epsilonrt/gp2-i2c/hardware/proto/lpkf/gp2-i2c - CADCAM Mechanical 1.TXT

G04 PROTEUS RS274X GERBER FILE*
%FSLAX24Y24*%
%MOIN*%
%ADD71C,0.0080*%
G54D71*
X-984Y-3937D02*
X+12795Y-3937D01*
X+12795Y+1574D01*
X-984Y+1574D01*
X-984Y-3937D01*
M00*
