epsilonrt/gp2-i2c/doc/gp2-mesures.odt

# Mesures

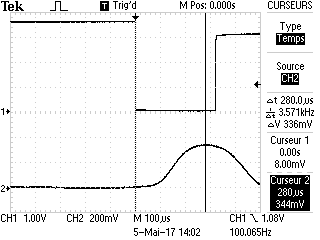
[picture p2: figure]

| C1 : LED Pin3 C2 : VO Pin5 Moyenne sur 16 courbes Pas de fumée Mesure délai échantillonnage 280µs Mesure VO à 280µs, 336mV

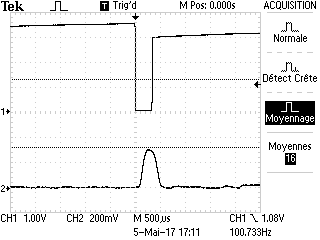
[picture p3: figure]

| C1 : LED Pin3 C2 : VO Pin5 Moyenne sur 16 courbes Pas de fumée

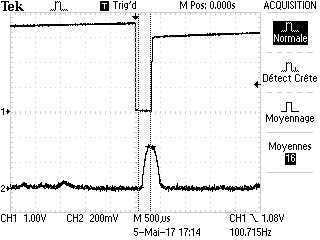
[picture p4: figure]

| C1 : LED Pin3 C2 : VO Pin5 Sans moyenne Pas de fumée

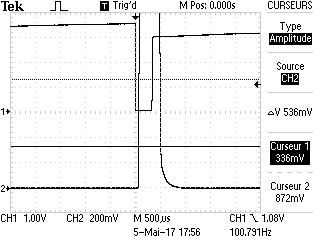
[picture p5: figure]

| C1 : LED Pin3 C2 : VO Pin5 Moyenne sur 16 courbes Fumée de cigarette électronique

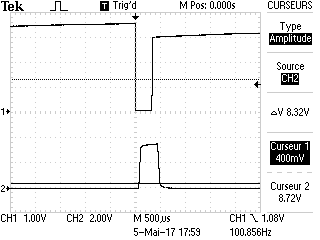
[picture p6: figure]

| C1 : LED Pin3 C2 : VO Pin5 Moyenne sur 16 courbes Fumée de cigarette électronique, saturation capteur à 3,8V

Capteur GP2Y1010AU0F > Mesures

P. JEAN2017 g2p-mesures.odt version 1.0 page 1/2

P. JEAN g2p-mesures.odt version 1.0 page 1/2
