epsilonrt/gp2-i2c/hardware/gp2-i2c-sch.pdf

U2

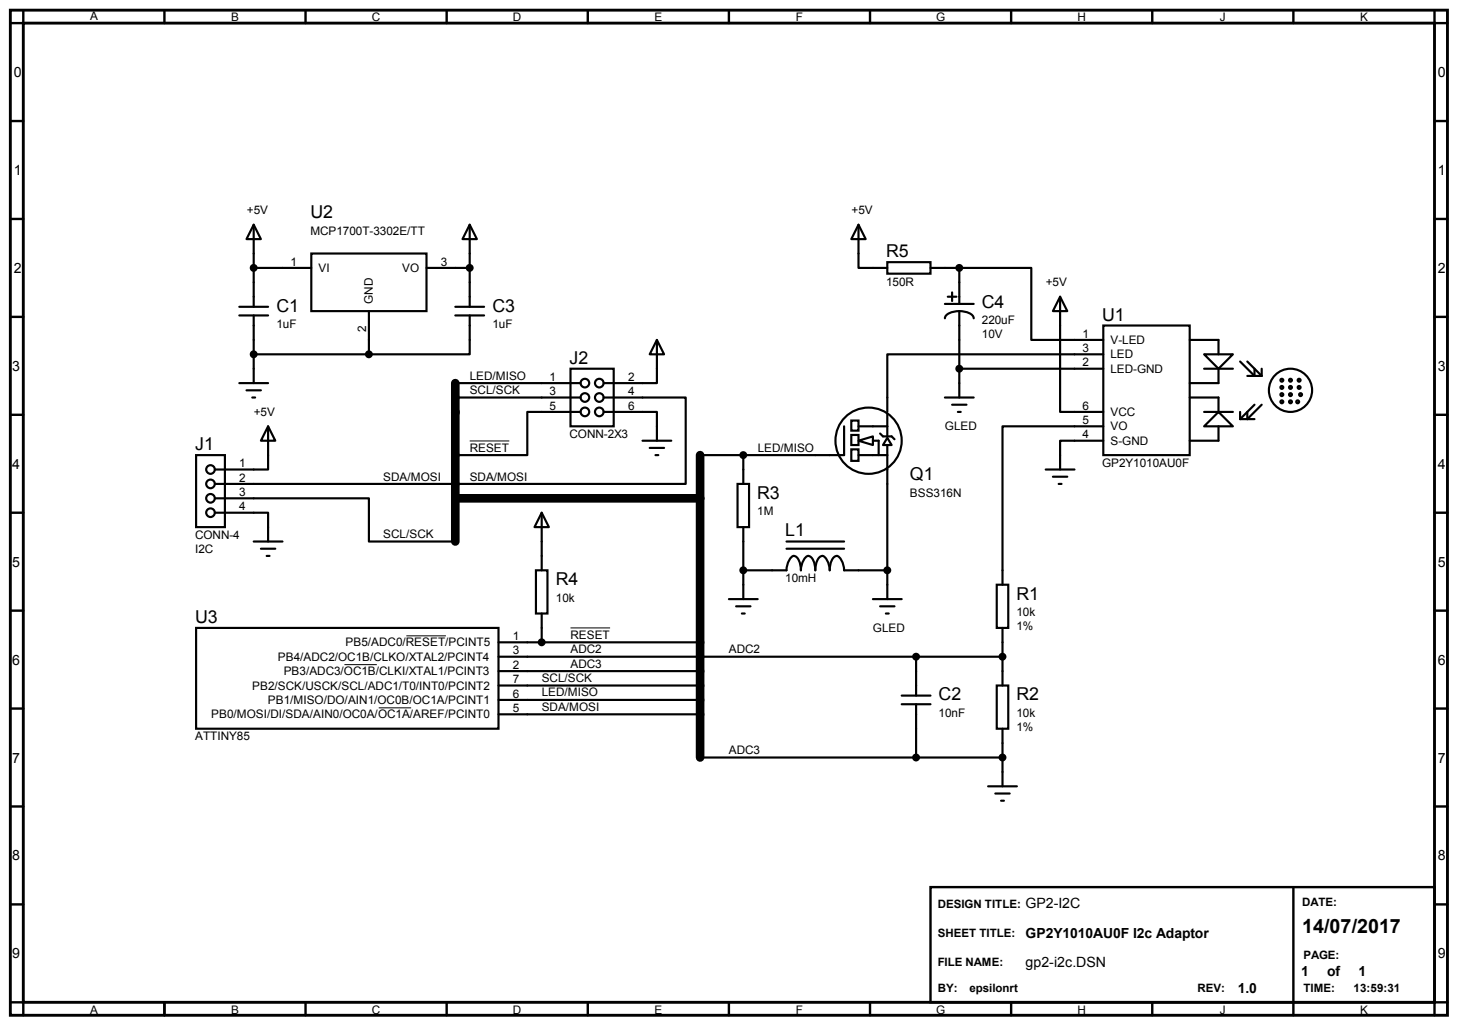
[picture p7: page 1]
