epsilonrt/gp2-i2c/(list of files, drawings)

Other design files:
hardware/gp2-i2c.DSN
hardware/proto/gp2-i2c.DSN
hardware/proto/gp2-i2c.LYT
