epsilonrt/gp2-i2c/doc/gp2-i2c-test-20170521.ods

time | v | h
1495360848 | 375 | 0x177
1495360859 | 399 | 0x18F
1495360870 | 388 | 0x184
1495360881 | 382 | 0x17E
1495360892 | 399 | 0x18F
1495360903 | 394 | 0x18A
1495360914 | 398 | 0x18E
1495360925 | 385 | 0x181
1495360936 | 375 | 0x177
1495360947 | 379 | 0x17B
1495360958 | 393 | 0x189
1495360969 | 412 | 0x19C
1495360980 | 393 | 0x189
1495360991 | 400 | 0x190
1495361002 | 403 | 0x193
1495361013 | 397 | 0x18D
1495361024 | 387 | 0x183
1495361035 | 385 | 0x181
1495361046 | 382 | 0x17E
1495361057 | 384 | 0x180
1495361068 | 394 | 0x18A
1495361079 | 396 | 0x18C
1495361090 | 387 | 0x183
1495361101 | 375 | 0x177
1495361112 | 413 | 0x19D
1495361123 | 399 | 0x18F
1495361134 | 402 | 0x192
1495361145 | 388 | 0x184
1495361156 | 405 | 0x195
1495361167 | 374 | 0x176
1495361178 | 389 | 0x185
1495361189 | 390 | 0x186
1495361200 | 380 | 0x17C
1495361211 | 383 | 0x17F
1495361222 | 390 | 0x186
1495361233 | 390 | 0x186
1495361244 | 400 | 0x190
1495361255 | 381 | 0x17D
1495361266 | 395 | 0x18B
1495361277 | 386 | 0x182
1495361288 | 389 | 0x185
1495361299 | 386 | 0x182
1495361310 | 382 | 0x17E
1495361321 | 399 | 0x18F
1495361332 | 392 | 0x188
1495361343 | 379 | 0x17B
1495361354 | 390 | 0x186
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
