epsilonrt/gp2-i2c/(commit log)

2017-07-13 Version 1.0
    [domogik-iaq.DSN, domogik-iaq.LYT, gp2-i2c-template.LYT, gp2-i2c-test-20170521.ods, gp2-i2c.DSN, gp2-i2c.LYT]
2017-07-14 Séparation prototype hardware
    [domogik-iaq.DSN, domogik-iaq.LYT, gp2-i2c-template.LYT, gp2-i2c.DSN, gp2-i2c.LYT]
2017-07-14 Erreurs de formatage markdown
